eSpark-Consulting-Group/elijahkorp-controlproject/Design_files/Control_Board/Deliverables/Renderings/3D_Isometric.PNG

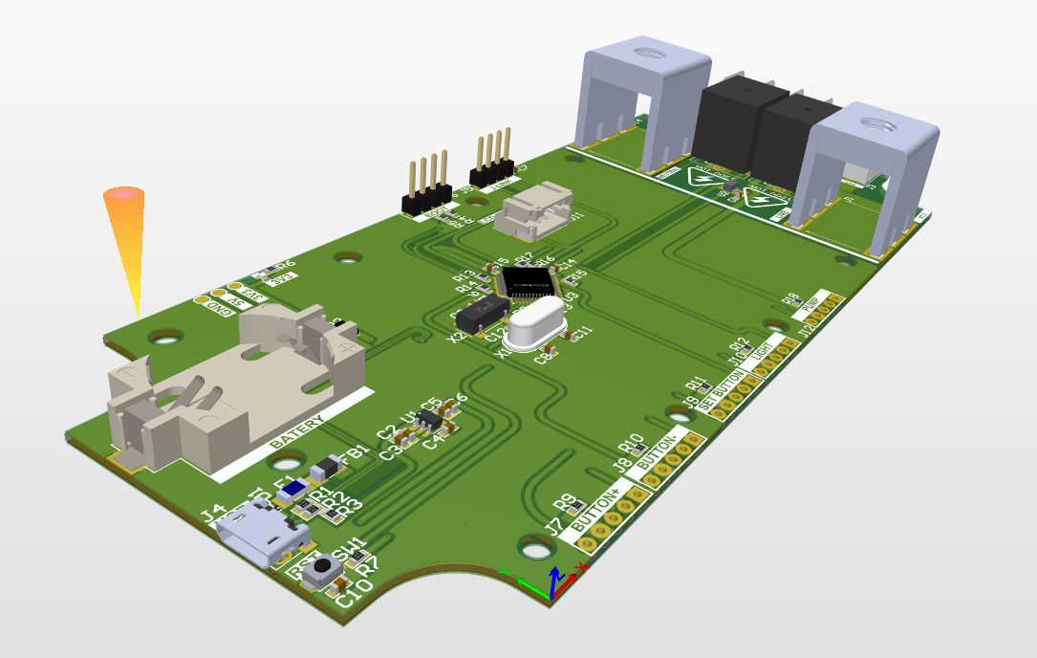
Design_files/Control_Board/Deliverables/Renderings/3D_Isometric.PNG
