eSpark-Consulting-Group/elijahkorp-controlproject/Design_files/Control_Board/Deliverables/Renderings/2D_Top_View.PNG

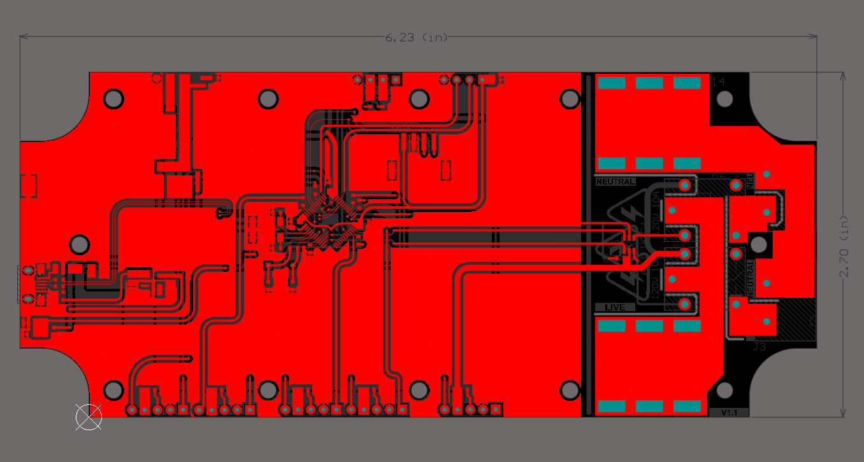
Design_files/Control_Board/Deliverables/Renderings/2D_Top_View.PNG
