eSpark-Consulting-Group/elijahkorp-controlproject/Design_files/Control_Board/Deliverables/Renderings/3D_Bottom.PNG

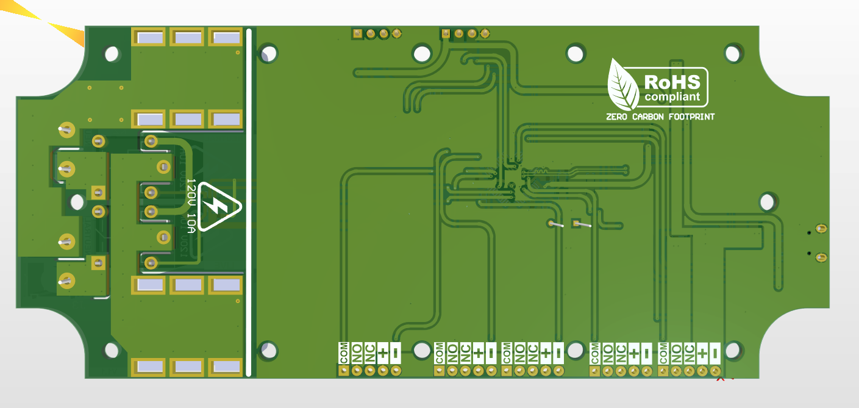
Design_files/Control_Board/Deliverables/Renderings/3D_Bottom.PNG
