eSpark-Consulting-Group/elijahkorp-controlproject/Design_files/Control_Board/Deliverables/BOM/Client BOM.xlsx

Sheet: 5 Boards
 |  | Component list |  | Bill of Materials for Project [Control_Board.]
 |  | Source Data From: |  | Control_Board
 |  | Project: |  | Control_Board
 |  | Variant: |  | None
# | Item Type | Designator | Description | Footprint | Manufacturer Part Number | Manufacturer | Value | Quantity | Quantity (10 Boards) | Link | Remarks
1 | Capacitor | C1, C2, C5, C7, C13, C14, C15, C16 | CS Series 0603 0.1 uF 25 V ±10% X7R Multilayer Ceramic Capacitor | Cap-0603 | CS0603KRX7R8BB104 | Yageo | 0.1uF | 8 | 40
2 | Capacitor | C3, C6 | CAP CER 10UF 25V X5R 0603 | Cap-0603 | CL10A106MA8NRNC | Samsung | 10uF | 2 | 10
3 | Capacitor | C4 | 25V 22nF X7R 0603 Multilayer Ceramic Capacitors MLCC - SMD/SMT ROHS | Cap-0603 | FN18X223K250PSG | PSA(Prosperity Dielectrics) | 22nF | 1 | 5
4 | Capacitor | C8, C11 | CAP 30pF NP0 0603 50 V ±5 % SMD | Cap-0603 | CC0603JRNPO9BN300 | Yageo | 30pF | 2 | 10
5 | Capacitor | C9, C12 | CAP CER 15PF 50V C0G/NPO 0603 | Cap-0603 | CC0603JRNPO9BN150 | Yageo | 15pF | 2 | 10
6 | Capacitor | C10 | 1uF 25V X5R ±20% 0603 Multilayer Ceramic Capacitors MLCC - SMD/SMT ROHS | Cap-0603 | TCC0603X5R105M250CT | CCTC | 1uF | 1 | 5
7 | Diode | D1 | TVS DIODE 5VWM 6.3VC DSN0603-2 | DSN0603-2 | PESD5V0H1BSFYL | Nexperia | - | 1 | 5
8 | Diode | D2 | 30V Dual Common Cathode 1V@100mA 200mA SOT-23(TO-236) Schottky Barrier Diodes (SBD) ROHS | SOT-23 | BAT54C | Shandong Jingdao Microelectronics | - | 1 | 5
9 | Fuse | F1 | PTC RESET FUSE 6V 3A 1206 | Fuse 1206 (3216 Metric) | 1206L300SLTHYR | Littelfuse | - | 1 | 5
10 | Ferrite Bead | FB1 | FERRITE BEAD 120 OHM 1206 1LN | IND-1206 | BLM31PG121SN1L | Murata | - | 1 | 5
11 | PCB Welding Terminal | J1, J14 | 7.5mm 240A 20mm M6 - PCB Welding Terminal ROHS | ACTB273-CU-T2 | ACTB273-Cu-T2 | CNNT(Shenzhen Connection Elec) |  | 2 | 10
12 | Terminal Block | J1, J2, J3 | Tin 2x1P 2 1 7.62mm -40℃~+105℃ 20A 300V Green 12~22 Straight pin Copper Alloy 2.5 Plugin,P=7.62mm Barrier Terminal Blocks ROHS | Custom | MX7620-7.62-02P-GN01-Cu-S-A | MAX | - | 3 | 15
13 | USB | J4 | 1.8A USB 2.0 1 260℃ Surface Mount 5P Female -40℃~+85℃ Gold Copper Alloy Micro-B SMD USB Connectors ROHS | Custom | U254-051T-4BH83-F1S | XKB Connectivity | - | 1 | 5
14 | Header | J5, J6 | Straight 2.54mm Black Brass 1x4P Plugin,P=2.54mm Pin Headers ROHS | HDR1X4_ | B-2100S04P-A110 | Ckmtw | - | 2 | 10
15 | Through Hole Pads | J7, J8, J9, J10, J12 | Wire Connecting Pads | Custom | 5P Through Hole Pads |  | DNP | 5 | 25
16 | Connector | J11 | 1x4P 1 2mm Male pin 4 -25℃~+85℃ 2A Surface Mount SMD,P=2mm Wire To Board / Wire To Wire Connector ROHS C3029442 | Custom | WAFER-PH2.0-4PWB | XUNPU | - | 1 | 5
17 | Connector | J13 | Battery base CR2032 SMD Battery Connectors ROHS | Custom | CR2032-BS-6-1 | Q&J | - | 1 | 5
18 | Relay | K1, K2 | 5V 10A 20A@14VAC SPDT (1 Form C) 5 Plugin,12.4x16mm Power Relays ROHS | Custom | SRA-05VDC-CL | Ningbo Songle Relay | - | 2 | 10
19 | LED | LED6 | Colorless transparence -30℃~+85℃ Positive post 617nm~621nm Red 120° 55mW 0603 Light Emitting Diodes (LED) ROHS | LED-0603 | XL-1608SURC-06 | XINGLIGHT | - | 1 | 5
20 | TEST POINT | P1, P2, P3 | Test Point ON | Custom | Test-point | - | - | 3 | 15
21 | Resistor | R1, R2 | 100mW Thick Film Resistors ±100ppm/℃ ±1% 20Ω 0603 Chip Resistor - Surface Mount ROHS | Res-0603 | 0603WAF200JT5E | UNI-ROYAL(Uniroyal Elec) | 20R | 2 | 10
22 | Resistor | R3 | RES SMD 4.7K OHM 5% 1/10W 0603 | Res-0603 | RC0603JR-074K7L | Yageo | 4.7K | 1 | 5
23 | Resistor | R6 | 100mW Thick Film Resistors ±100ppm/℃ ±1% 60.4Ω 0603 Chip Resistor - Surface Mount ROHS | Res-0603 | RTT0360R4FTP | RALEC | 60.4R | 1 | 5
24 | Resistor | R4, R5, R9, R10, R11, R12, R18,R7 | RES SMD 10K Ohm 1% 1/10W 0603 | Res-0603 | RC0603FR-0710KL | Yageo | 10K | 8 | 40
25 | Resistor | R8 | 100mW Thick Film Resistors ±100ppm/℃ ±1% 1MΩ 0603 Chip Resistor - Surface Mount ROHS | Res-0603 | 0603WAF1004T5E | UNI-ROYAL(Uniroyal Elec) | 1M | 1 | 5
26 | Resistor | R13, R14, R15, R16, R17 | RES SMD 330R 100 mW 0603 | Res-0603 | RC0603JR-07330RL | Yageo | 330R | 5 | 25
27 | Switch | SW1 | SWITCH TACTILE SPST-NO 0.05A 12V | Custom | B3U-1000P | Omron | - | 1 | 5
28 | IC | U1 | IC REG LDO 3.3V 0.3A SOT23-5 | SOT-23-5 | RT9193-33GB | Richtek | - | 1 | 5
29 | IC | U2 | SOT-23-6 Darlington Transistor Arrays ROHS | SOT-23-6 | LK1802 | LANKE | - | 1 | 5
30 | IC | U3 | ARM Cortex-M3 STM32 F1 Microcontroller 32-Bit 72MHz 64kB FLASH LQFP48 STM32F103C8T6 | 48-LQFP (7x7)_ | STM32F103C8T6 | STMicroelectronics | - | 1 | 5
31 | Crystal | X1 | 8MHz 20pF ±20ppm HC-49S Crystals ROHS | Custom | 71008000RW1 | HD | 8Mhz | 1 | 5
32 | Crystal | X2 | 32.768kHz 12.5pF ±20ppm MC-306 Crystals ROHS | Custom | MC-306 | Seiko Epson | 32.768kHz | 1 | 5
33 | Peripheral | - | 19mm Waterproof Momentary Latching Metal Doorbell Bell Horn Push Button Switch LED Ring Mark Fixation 5V 12V 24V 220 Lock Reset | - | White LED Button | - |  | 3 | 15 | Aliexpress (https://vi.aliexpress.com/item/32899654309.html?gatewayAdapt=glo2vnm)
34 | Peripheral | - | 19mm Waterproof Momentary Latching Metal Doorbell Bell Horn Push Button Switch LED Ring Mark Fixation 5V 12V 24V 220 Lock Reset | - | Red LED Button | - |  | 2 | 10 | Aliexpress (https://vi.aliexpress.com/item/32899654309.html?gatewayAdapt=glo2vnm)
35 | Peripheral | - | 10A 250V C13 C14 Waterproof Black electric bicycle car wired Receptacle Connector battery Charging AC power outlet Socket | - | - | - | - | 1 | 5 | Aliexpress (https://www.aliexpress.us/item/1005004421431950.html?gatewayAdapt=4itemAdapt)
36 | Peripheral | - | Original For Panasonic CR2032 CR 2032 DL2032 ECR2032 Lithium Battery Watch Calculator Car Key Remote Control Button Coin Cells | - | CR2032 | Panasonic | - | 1 | 5 | Aliexpress (https://vi.aliexpress.com/item/1005005930259581.html)
37 | Peripheral | - | Network cables ROHS | - | LDS200-100726-200-4P | DEALON | - | 1 | 5 | LCSC (https://www.lcsc.com/product-detail/Network-cables_DEALON-LDS200-100726-200-4P_C2999019.html)
38 | Peripheral | - | 162 16X2 1602 AIP31068L Serial I2C IIC Character LCD Module Display Screen LCM for Arduino RaspBerry Pi PICO ESP32 Jetson Nano | - | - | - | - | 1 | 5 | Aliexpress (https://www.aliexpress.com/item/4000386970133.html)

Sheet: 10 Boards
 |  | Component list |  | Bill of Materials for Project [Control_Board.]
 |  | Source Data From: |  | Control_Board
 |  | Project: |  | Control_Board
 |  | Variant: |  | None
# | Item Type | Designator | Description | Footprint | Manufacturer Part Number | Manufacturer | Value | Quantity | Quantity (10 Boards) | Link | Remarks
1 | Capacitor | C1, C2, C5, C7, C13, C14, C15, C16 | CS Series 0603 0.1 uF 25 V ±10% X7R Multilayer Ceramic Capacitor | Cap-0603 | CS0603KRX7R8BB104 | Yageo | 0.1uF | 8 | 80
2 | Capacitor | C3, C6 | CAP CER 10UF 25V X5R 0603 | Cap-0603 | CL10A106MA8NRNC | Samsung | 10uF | 2 | 20
3 | Capacitor | C4 | 25V 22nF X7R 0603 Multilayer Ceramic Capacitors MLCC - SMD/SMT ROHS | Cap-0603 | FN18X223K250PSG | PSA(Prosperity Dielectrics) | 22nF | 1 | 10
4 | Capacitor | C8, C11 | CAP 30pF NP0 0603 50 V ±5 % SMD | Cap-0603 | CC0603JRNPO9BN300 | Yageo | 30pF | 2 | 20
5 | Capacitor | C9, C12 | CAP CER 15PF 50V C0G/NPO 0603 | Cap-0603 | CC0603JRNPO9BN150 | Yageo | 15pF | 2 | 20
6 | Capacitor | C10 | 1uF 25V X5R ±20% 0603 Multilayer Ceramic Capacitors MLCC - SMD/SMT ROHS | Cap-0603 | TCC0603X5R105M250CT | CCTC | 1uF | 1 | 10
7 | Diode | D1 | TVS DIODE 5VWM 6.3VC DSN0603-2 | DSN0603-2 | PESD5V0H1BSFYL | Nexperia | - | 1 | 10
8 | Diode | D2 | 30V Dual Common Cathode 1V@100mA 200mA SOT-23(TO-236) Schottky Barrier Diodes (SBD) ROHS | SOT-23 | BAT54C | Shandong Jingdao Microelectronics | - | 1 | 10
9 | Fuse | F1 | PTC RESET FUSE 6V 3A 1206 | Fuse 1206 (3216 Metric) | 1206L300SLTHYR | Littelfuse | - | 1 | 10
10 | Ferrite Bead | FB1 | FERRITE BEAD 120 OHM 1206 1LN | IND-1206 | BLM31PG121SN1L | Murata | - | 1 | 10
11 | Terminal Block | J1, J2, J3 | Tin 2x1P 2 1 7.62mm -40℃~+105℃ 20A 300V Green 12~22 Straight pin Copper Alloy 2.5 Plugin,P=7.62mm Barrier Terminal Blocks ROHS | Custom | MX7620-7.62-02P-GN01-Cu-S-A | MAX | - | 3 | 30
12 | USB | J4 | 1.8A USB 2.0 1 260℃ Surface Mount 5P Female -40℃~+85℃ Gold Copper Alloy Micro-B SMD USB Connectors ROHS | Custom | U254-051T-4BH83-F1S | XKB Connectivity | - | 1 | 10
13 | Header | J5, J6 | Straight 2.54mm Black Brass 1x4P Plugin,P=2.54mm Pin Headers ROHS | HDR1X4_ | B-2100S04P-A110 | Ckmtw | - | 2 | 20
14 | Through Hole Pads | J7, J8, J9, J10, J12 | Wire Connecting Pads | Custom | 5P Through Hole Pads | - | DNP | 5 | 50
15 | Connector | J11 | 1x4P 1 2mm Male pin 4 -25℃~+85℃ 2A Surface Mount SMD,P=2mm Wire To Board / Wire To Wire Connector ROHS C3029442 | Custom | WAFER-PH2.0-4PWB | XUNPU | - | 1 | 10
16 | Connector | J13 | Battery base CR2032 SMD Battery Connectors ROHS | Custom | CR2032-BS-6-1 | Q&J | - | 1 | 10
17 | Relay | K1, K2 | 5V 10A 20A@14VAC SPDT (1 Form C) 5 Plugin,12.4x16mm Power Relays ROHS | Custom | SRA-05VDC-CL | Ningbo Songle Relay | - | 2 | 20
18 | LED | LED6 | Colorless transparence -30℃~+85℃ Positive post 617nm~621nm Red 120° 55mW 0603 Light Emitting Diodes (LED) ROHS | LED-0603 | XL-1608SURC-06 | XINGLIGHT | - | 1 | 10
19 | TEST POINT | P1, P2, P3 | Test Point ON | Custom | Test-point | - | - | 3 | 30
20 | Resistor | R1, R2 | 100mW Thick Film Resistors ±100ppm/℃ ±1% 20Ω 0603 Chip Resistor - Surface Mount ROHS | Res-0603 | 0603WAF200JT5E | UNI-ROYAL(Uniroyal Elec) | 20R | 2 | 20
21 | Resistor | R3 | 100mW Thick Film Resistors ±100ppm/℃ ±1% 1.5kΩ 0603 Chip Resistor - Surface Mount ROHS | Res-0603 | 0603WAF1501T5E | UNI-ROYAL(Uniroyal Elec) | 1.5K | 1 | 10
22 | Resistor | R4, R5, R9, R10, R11, R12, R18 | RES SMD 10K OHM 0.1% 1/10W 0603 | Res-0603 | RT0603BRD0710KL | Yageo | 10K | 7 | 70
23 | Resistor | R6 | 100mW Thick Film Resistors ±100ppm/℃ ±1% 60.4Ω 0603 Chip Resistor - Surface Mount ROHS | Res-0603 | RTT0360R4FTP | RALEC | 60.4R | 1 | 10
24 | Resistor | R7 | RES SMD 10K Ohm 1% 1/10W 0603 | Res-0603 | RC0603FR-0710KL | Yageo | 10K | 1 | 10
25 | Resistor | R8 | 100mW Thick Film Resistors ±100ppm/℃ ±1% 1MΩ 0603 Chip Resistor - Surface Mount ROHS | Res-0603 | 0603WAF1004T5E | UNI-ROYAL(Uniroyal Elec) | 1M | 1 | 10
26 | Resistor | R13, R14, R15, R16, R17 | RES SMD 330R 100 mW 0603 | Res-0603 | RC0603JR-07330RL | Yageo | 330R | 5 | 50
27 | Switch | SW1 | SWITCH TACTILE SPST-NO 0.05A 12V | Custom | B3U-1000P | Omron | - | 1 | 10
28 | IC | U1 |  | SOT-23-5 | RT9193-33GB | Richtek | - | 1 | 10
29 | IC | U2 | SOT-23-6 Darlington Transistor Arrays ROHS | SOT-23-6 | LK1802 | LANKE | - | 1 | 10
30 | IC | U3 | Mainstream Performance line, Arm | 48-LQFP (7x7)_ | STM32F103C8T6 | STMicroelectronics | - | 1 | 10
31 | Crystal | X1 | 8MHz 20pF ±20ppm HC-49S Crystals ROHS | Custom | 71008000RW1 | HD | 8Mhz | 1 | 10
32 | Crystal | X2 | 32.768kHz 12.5pF ±20ppm MC-306 Crystals ROHS | Custom | MC-306 | Seiko Epson | 32.768kHz | 1 | 10
33 | Peripheral | - | 19mm Waterproof Momentary Latching Metal Doorbell Bell Horn Push Button Switch LED Ring Mark Fixation 5V 12V 24V 220 Lock Reset | - | White LED Button | - |  | 3 | 30 | Aliexpress (https://vi.aliexpress.com/item/32899654309.html?gatewayAdapt=glo2vnm)
34 | Peripheral | - | 19mm Waterproof Momentary Latching Metal Doorbell Bell Horn Push Button Switch LED Ring Mark Fixation 5V 12V 24V 220 Lock Reset | - | Red LED Button | - |  | 2 | 20 | Aliexpress (https://vi.aliexpress.com/item/32899654309.html?gatewayAdapt=glo2vnm)
35 | Peripheral | - | 10A 250V C13 C14 Waterproof Black electric bicycle car wired Receptacle Connector battery Charging AC power outlet Socket | - | - | - | - | 1 | 10 | Aliexpress (https://www.aliexpress.us/item/1005004421431950.html?gatewayAdapt=4itemAdapt)
36 | Peripheral | - | Original For Panasonic CR2032 CR 2032 DL2032 ECR2032 Lithium Battery Watch Calculator Car Key Remote Control Button Coin Cells | - | CR2032 | Panasonic | - | 1 | 10 | Aliexpress (https://vi.aliexpress.com/item/1005005930259581.html)
37 | Peripheral | - | Network cables ROHS | - | LDS200-100726-200-4P | DEALON | - | 1 | 10 | LCSC (https://www.lcsc.com/product-detail/Network-cables_DEALON-LDS200-100726-200-4P_C2999019.html)
38 | Peripheral | - | 162 16X2 1602 AIP31068L Serial I2C IIC Character LCD Module Display Screen LCM for Arduino RaspBerry Pi PICO ESP32 Jetson Nano | - | - | - | - | 1 | 10 | Aliexpress (https://www.aliexpress.com/item/4000386970133.html)
