eSpark-Consulting-Group/elijahkorp-controlproject/Design_files/Control_Board/Deliverables/BOM/eSpark-BOM-Control_Board-v1.0.xlsx

Sheet: 5 Boards
 |  | Component list |  | Bill of Materials for Project [Control_Board-v1.0]
 |  | Source Data From: |  | Control_Board-v1.0
 |  | Project: |  | Control_Board-v1.0
 |  | Variant: |  | None
# | Item Type | Designator | Description | Footprint | Manufacturer Part Number | Manufacturer | Alternate Part Number | LCSC Part Number | Value | Quantity | Quantity (5 Boards) | MOQ (5 Boards) | Links | Unit Cost (5 Boards) | Total Cost (5 Boards) | Remarks | Reviewer Remarks
1 | Capacitor | C1, C2, C5, C7, C13, C14, C15, C16 | CAP CER 0.1UF 25V X7R 0603 | Cap-0603 | CS0603KRX7R8BB104 | Yageo | - | C577419 | 0.1uF | 8 | 40 | 50 | LCSC (https://www.lcsc.com/product-detail/Multilayer-Ceramic-Capacitors-MLCC-SMD-SMT_YAGEO-CS0603KRX7R8BB104_C577419.html) | $0.0117 | $0.5850
2 | Capacitor | C3, C6 | CAP CER 10UF 25V X5R 0603 | Cap-0603 | CL10A106MA8NRNC | Samsung | - | C96446 | 10uF | 2 | 10 | 20 | LCSC (https://www.lcsc.com/product-detail/Multilayer-Ceramic-Capacitors-MLCC-SMD-SMT_Samsung-Electro-Mechanics-CL10A106MA8NRNC_C96446.html) | $0.0193 | $0.3860
3 | Capacitor | C4 | 25V 22nF X7R 0603 Multilayer Ceramic Capacitors MLCC - SMD/SMT ROHS | Cap-0603 | FN18X223K250PSG | PSA(Prosperity Dielectrics) | - | C2929161 | 22nF | 1 | 5 | 100 | LCSC (https://www.lcsc.com/product-detail/Multilayer-Ceramic-Capacitors-MLCC-SMD-SMT_PSA-Prosperity-Dielectrics-FN18X223K250PSG_C2929161.html) | $0.0039 | $0.3900
4 | Capacitor | C8, C11 | CAP 30pF NP0 0603 50 V ±5 % SMD | Cap-0603 | CC0603JRNPO9BN300 | Yageo | - | C113797 | 30pF | 2 | 10 | 100 | LCSC (https://www.lcsc.com/product-detail/Multilayer-Ceramic-Capacitors-MLCC-SMD-SMT_YAGEO-CC0603JRNPO9BN300_C113797.html) | $0.0029 | $0.2900
5 | Capacitor | C9, C12 | CAP CER 15PF 50V C0G/NPO 0603 | Cap-0603 | CC0603JRNPO9BN150 | Yageo | - | C107037 | 15pF | 2 | 10 | 100 | LCSC (https://www.lcsc.com/product-detail/Multilayer-Ceramic-Capacitors-MLCC-SMD-SMT_YAGEO-CC0603JRNPO9BN150_C107037.html) | $0.0030 | $0.3000
6 | Capacitor | C10 | 1uF 25V X5R ±20% 0603 Multilayer Ceramic Capacitors MLCC - SMD/SMT ROHS | Cap-0603 | TCC0603X5R105M250CT | CCTC | - | C6266891 | 1uF | 1 | 5 | 100 | LCSC (https://www.lcsc.com/product-detail/Multilayer-Ceramic-Capacitors-MLCC-SMD-SMT_CCTC-TCC0603X5R105M250CT_C6266891.html) | $0.0042 | $0.4200
7 | Diode | D1 | TVS DIODE 5VWM 6.3VC DSN0603-2 | DSN0603-2 | PESD5V0H1BSFYL | Nexperia | - | C477989 | - | 1 | 5 | 10 | LCSC (https://www.lcsc.com/product-detail/ESD-Protection-Devices_Nexperia-PESD5V0H1BSF_C477989.html) | $0.0339 | $0.3390
8 | Diode | D2 | 30V Dual Common Cathode 1V@100mA 200mA SOT-23 Schottky Barrier Diodes (SBD) ROHS | SOT-23 | BAT54C | Shandong Jingdao Microelectronics | - | C727125 | - | 1 | 5 | 50 | LCSC (https://www.lcsc.com/product-detail/Schottky-Barrier-Diodes-SBD_TWGMC-BAT54C_C727125.html) | $0.0103 | $0.5150
9 | Fuse | F1 | PTC RESET FUSE 6V 3A 1206 | Fuse 1206 (3216 Metric) | 1206L300SLTHYR | Littelfuse | - | C207041 | - | 1 | 5 | 10 | LCSC (https://www.lcsc.com/product-detail/Resettable-Fuses_Littelfuse-1206L300SLTHYR_C207041.html) | $0.2237 | $2.2370
10 | Ferrite Bead | FB1 | FERRITE BEAD 120 OHM 1206 1LN | IND-1206 | BLM31PG121SN1L | Murata | - | C85841 | - | 1 | 5 | 10 | LCSC (https://www.lcsc.com/product-detail/Ferrite-Beads_Murata-Electronics-BLM31PG121SN1L_C85841.html) | $0.0803 | $0.8030
11 | PCB Welding Terminal | J1, J14 | 7.5mm 240A 20mm M6 - PCB Welding Terminal ROHS | ACTB273-CU-T2 | ACTB273-Cu-T2 | CNNT(Shenzhen Connection Elec) |  | - | - | 2 | 10 | 10 | JLCPCB (https://jlcpcb.com/partdetail/5781967-ACTB273_CuT2/C5154233) | $1.5135 | $15.1350
12 | Terminal Block | J1, J2, J3 | Tin 2x1P 2 1 7.62mm -40℃~+105℃ 20A 300V Green 12~22 Straight pin Copper Alloy 2.5 Plugin,P=7.62mm Barrier Terminal Blocks ROHS | Custom | MX7620-7.62-02P-GN01-Cu-S-A | MAX | - | C5188497 | - | 3 | 15 | 20 | LCSC (https://www.lcsc.com/product-detail/Barrier-Terminal-Blocks_MAX-MX7620-7-62-02P-GN01-Cu-S-A_C5188497.html) | $0.0758 | $1.5160
13 | USB | J4 | 1.8A USB 2.0 1 260℃ Surface Mount 5P Female -40℃~+85℃ Gold Copper Alloy Micro-B SMD USB Connectors ROHS | Custom | U254-051T-4BH83-F1S | XKB Connectivity | - | C397452 | - | 1 | 5 | 10 | LCSC (https://www.lcsc.com/product-detail/USB-Connectors_XKB-Connectivity-U254-051T-4BH83-F1S_C397452.html) | $0.0404 | $0.4040
14 | Header | J5, J6 | Straight 2.54mm Black Brass 1x4P Plugin,P=2.54mm Pin Headers ROHS | HDR1X4_ | B-2100S04P-A110 | Ckmtw | - | C124378 |  | 2 | 10 | 20 | LCSC (https://www.lcsc.com/product-detail/Pin-Headers_Ckmtw-Shenzhen-Cankemeng-B-2100S04P-A110_C124378.html) | $0.0402 | $0.8040
15 | Through Hole Pads | ~~J7, J8, J9, J10, J12~~ | ~~Wire Connecting Pads~~ | ~~Custom~~ | ~~5P Through Hole Pads~~ | ~~-~~ | ~~-~~ | ~~-~~ | ~~DNP~~ | ~~5~~ | ~~25~~ | ~~-~~ | ~~-~~ | ~~-~~ | ~~-~~
16 | Connector | J11 | 1x4P 1 2mm Male pin 4 -25℃~+85℃ 2A Surface Mount SMD,P=2mm Wire To Board / Wire To Wire Connector ROHS C3029442 | Custom | WAFER-PH2.0-4PWB | XUNPU | - | C3029442 | - | 1 | 5 | 10 | LCSC (https://www.lcsc.com/product-detail/Wire-To-Board-Wire-To-Wire-Connector_XUNPU-WAFER-PH2-0-4PWB_C3029442.html) | $0.0624 | $0.6240
17 | Connector | J13 | Battery base CR2032 SMD Battery Connectors ROHS | Custom | CR2032-BS-6-1 | Q&J | - | C70377 |  | 1 | 5 | 10 | LCSC (https://www.lcsc.com/product-detail/Battery-Connectors_Q-J-CR2032-BS-6-1_C70377.html) | $0.1559 | $1.5590
18 | Relay | K1, K2 | 5V 10A 20A@14VAC SPDT (1 Form C) 5 Plugin,12.4x16mm Power Relays ROHS | Custom | SRA-05VDC-CL | Ningbo Songle Relay | - | C99666 |  | 2 | 10 | 15 | LCSC (https://www.lcsc.com/product-detail/Power-Relays_Ningbo-Songle-Relay-SRA-05VDC-CL_C99666.html) | $0.3444 | $5.1660
19 | LED | LED6 | Colorless transparence -30℃~+85℃ Positive post 617nm~621nm Red 120° 55mW 0603 Light Emitting Diodes (LED) ROHS | LED-0603 | XL-1608SURC-06 | XINGLIGHT | - | C965799 |  | 1 | 5 | 100 | LCSC (https://www.lcsc.com/product-detail/Light-Emitting-Diodes-LED_XINGLIGHT-XL-1608SURC-06_C965799.html) | $0.0026 | $0.2600
20 | TEST POINT | ~~P1, P2, P3~~ | ~~Test Point ON~~ | ~~Custom~~ | ~~Test-point~~ | ~~-~~ | ~~-~~ | ~~-~~ |  | ~~3~~ | ~~15~~ | ~~-~~ | ~~-~~ | ~~-~~ | ~~-~~
21 | Resistor | R1, R2 | 100mW Thick Film Resistors ±100ppm/℃ ±1% 20Ω 0603 Chip Resistor - Surface Mount ROHS | Res-0603 | 0603WAF200JT5E | UNI-ROYAL(Uniroyal Elec) | - | C22950 | 20R | 2 | 10 | 100 | LCSC (https://www.lcsc.com/product-detail/Chip-Resistor-Surface-Mount_UNI-ROYAL-Uniroyal-Elec-0603WAF200JT5E_C22950.html) | $0.0010 | $0.1000
22 | Resistor | R3 | RES SMD 4.7K OHM 5% 1/10W 0603 | Res-0603 | RC0603JR-074K7L | Yageo |  | C105428 | 4.7K | 1 | 5 | 100 | LCSC (https://www.lcsc.com/product-detail/Chip-Resistor-Surface-Mount_YAGEO-RC0603JR-074K7L_C105428.html) | $0.0011 | $0.1100
23 | Resistor | R6 | 100mW Thick Film Resistors ±100ppm/℃ ±1% 60.4Ω 0603 Chip Resistor - Surface Mount ROHS | Res-0603 | RTT0360R4FTP | RALEC | - | C103744 | 60.4R | 1 | 5 | 100 | LCSC (https://www.lcsc.com/product-detail/Chip-Resistor-Surface-Mount_RALEC-RTT0360R4FTP_C103744.html) | $0.0010 | $0.1000
24 | Resistor | R4, R5, R9, R10, R11, R12, R18,R7 | RES SMD 10K Ohm 1% 1/10W 0603 | Res-0603 | RC0603FR-0710KL | Yageo | - | C98220 | 10K | 8 | 40 | 100 | LCSC (https://www.lcsc.com/product-detail/Chip-Resistor-Surface-Mount_YAGEO-RC0603FR-0710KL_C98220.html) | $0.0010 | $0.1000
25 | Resistor | R8 | 100mW Thick Film Resistors ±100ppm/℃ ±1% 1MΩ 0603 Chip Resistor - Surface Mount ROHS | Res-0603 | 0603WAF1004T5E | UNI-ROYAL(Uniroyal Elec) | - | C22935 | 1M | 1 | 5 | 100 | LCSC (https://www.lcsc.com/product-detail/Chip-Resistor-Surface-Mount_UNI-ROYAL-Uniroyal-Elec-0603WAF1004T5E_C22935.html) | $0.0010 | $0.1000
26 | Resistor | R13, R14, R15, R16, R17 | RES SMD 330R 100 mW 0603 | Res-0603 | RC0603JR-07330RL | Yageo | - | C105879 | 330R | 5 | 25 | 100 | LCSC (https://www.lcsc.com/product-detail/Chip-Resistor-Surface-Mount_YAGEO-RC0603JR-07330RL_C105879.html) | $0.0011 | $0.1100
27 | Switch | SW1 | SWITCH TACTILE SPST-NO 0.05A 12V | Custom | B3U-1000P | Omron | - | C231329 | - | 1 | 5 | 10 | LCSC (https://www.lcsc.com/product-detail/Tactile-Switches_Omron-Electronics-B3U-1000P_C231329.html) | $0.1729 | $1.7290
28 | IC | U1 | IC REG LDO 3.3V 0.3A SOT23-5 | SOT-23-5 | RT9193-33GB | Richtek | - | C15651 | - | 1 | 5 | 10 | LCSC (https://www.lcsc.com/product-detail/Linear-Voltage-Regulators-LDO_Richtek-Tech-RT9193-33GB_C15651.html) | $0.1154 | $1.1540
29 | IC | U2 | SOT-23-6 Darlington Transistor Arrays ROHS | SOT-23-6 | LK1802 | LANKE | - | C2984831 | - | 1 | 5 | 10 | LCSC (https://www.lcsc.com/product-detail/Darlington-Transistor-Arrays_LANKE-LK1802_C2984831.html) | $0.0531 | $0.5310
30 | IC | U3 | Mainstream Performance line, Arm | 48-LQFP (7x7)_ | STM32F103C8T6 | STMicroelectronics | - | C8734 | - | 1 | 5 | 6 | LCSC (https://www.lcsc.com/product-detail/Microcontroller-Units-MCUs-MPUs-SOCs_STMicroelectronics-STM32F103C8T6_C8734.html) | $1.4207 | $8.5242
31 | Crystal | X1 | 8MHz 20pF ±20ppm HC-49S Crystals ROHS | Custom | 71008000RW1 | HD | - | C655216 | 8Mhz | 1 | 5 | 10 | LCSC (https://www.lcsc.com/product-detail/Crystals_HD-71008000RW1_C655216.html) | $0.0574 | $0.5740
32 | Crystal | X2 | 32.768kHz 12.5pF ±20ppm MC-306 Crystals ROHS | Custom | MC-306 | Seiko Epson | - | C2650464 | 32.768kHz | 1 | 5 | 10 | LCSC (https://www.lcsc.com/product-detail/Crystals_Seiko-Epson-MC-306-32-7680K-A0-ROHS_C2650464.html) | $0.2728 | $2.7280
33 | Peripheral | - | 19mm Waterproof Momentary Latching Metal Doorbell Bell Horn Push Button Switch LED Ring Mark Fixation 5V 12V 24V 220 Lock Reset | - | White LED Button | - | - | - | - | 3 | 15 | 17 | Aliexpress (https://vi.aliexpress.com/item/32899654309.html?gatewayAdapt=glo2vnm) | $0.6900 | $11.7300
34 | Peripheral | - | 19mm Waterproof Momentary Latching Metal Doorbell Bell Horn Push Button Switch LED Ring Mark Fixation 5V 12V 24V 220 Lock Reset | - | Red LED Button | - | - | - | - | 2 | 10 | 12 | Aliexpress (https://vi.aliexpress.com/item/32899654309.html?gatewayAdapt=glo2vnm) | $0.6900 | $8.2800
35 | Peripheral | - | 10A 250V C13 C14 Waterproof Black electric bicycle car wired Receptacle Connector battery Charging AC power outlet Socket | - | - | - | - | - | - | 1 | 5 | 5 | Aliexpress (https://www.aliexpress.us/item/1005004421431950.html?gatewayAdapt=4itemAdapt) | $3.2300 | $16.1500
36 | Peripheral | - | Original For Panasonic CR2032 CR 2032 DL2032 ECR2032 Lithium Battery Watch Calculator Car Key Remote Control Button Coin Cells | - | CR2032 | Panasonic | - | - | - | 1 | 5 | 5 | Aliexpress (https://vi.aliexpress.com/item/1005005930259581.html) | $3.1800 | $15.9000
37 | Peripheral | - | Network cables ROHS | - | LDS200-100726-200-4P | DEALON | - | C2999019 | - | 1 | 5 | 5 | LCSC (https://www.lcsc.com/product-detail/Network-cables_DEALON-LDS200-100726-200-4P_C2999019.html) | $0.1147 | $0.5735
38 | Peripheral | - | 162 16X2 1602 AIP31068L Serial I2C IIC Character LCD Module Display Screen LCM for Arduino RaspBerry Pi PICO ESP32 Jetson Nano | - | - | - | - | - | - | 1 | 5 | 5 | Aliexpress (https://www.aliexpress.com/item/4000386970133.html) | $6.2900 | $31.4500
 |  |  |  |  |  |  |  |  |  |  |  | Total Component Cost |  |  | $131.68
 |  |  |  |  |  |  |  |  |  |  |  | Single Board Cost |  |  | $26.34

Sheet: 10 Boards
 |  | Component list |  | Bill of Materials for Project [Control_Board-v1.0]
 |  | Source Data From: |  | Control_Board-v1.0
 |  | Project: |  | Control_Board-v1.0
 |  | Variant: |  | None
# | Item Type | Designator | Description | Footprint | Manufacturer Part Number | Manufacturer | Alternate Part Number | LCSC Part Number | Value | Quantity | Quantity (10 Boards) | MOQ (10 Boards) | Links | Unit Cost (10 Boards) | Total Cost (10 Boards) | Remarks | Reviewer Remarks
1 | Capacitor | C1, C2, C5, C7, C13, C14, C15, C16 | CAP CER 0.1UF 25V X7R 0603 | Cap-0603 | CS0603KRX7R8BB104 | Yageo | - | C577419 | 0.1uF | 8 | 80 | 100 | LCSC (https://www.lcsc.com/product-detail/Multilayer-Ceramic-Capacitors-MLCC-SMD-SMT_YAGEO-CS0603KRX7R8BB104_C577419.html) | $0.0117 | $1.1700
2 | Capacitor | C3, C6 | CAP CER 10UF 25V X5R 0603 | Cap-0603 | CL10A106MA8NRNC | Samsung | - | C96446 | 10uF | 2 | 20 | 40 | LCSC (https://www.lcsc.com/product-detail/Multilayer-Ceramic-Capacitors-MLCC-SMD-SMT_Samsung-Electro-Mechanics-CL10A106MA8NRNC_C96446.html) | $0.0193 | $0.7720
3 | Capacitor | C4 | 25V 22nF X7R 0603 Multilayer Ceramic Capacitors MLCC - SMD/SMT ROHS | Cap-0603 | FN18X223K250PSG | PSA(Prosperity Dielectrics) | - | C2929161 | 22nF | 1 | 10 | 100 | LCSC (https://www.lcsc.com/product-detail/Multilayer-Ceramic-Capacitors-MLCC-SMD-SMT_PSA-Prosperity-Dielectrics-FN18X223K250PSG_C2929161.html) | $0.0039 | $0.3900
4 | Capacitor | C8, C11 | CAP 30pF NP0 0603 50 V ±5 % SMD | Cap-0603 | CC0603JRNPO9BN300 | Yageo | - | C113797 | 30pF | 2 | 20 | 100 | LCSC (https://www.lcsc.com/product-detail/Multilayer-Ceramic-Capacitors-MLCC-SMD-SMT_YAGEO-CC0603JRNPO9BN300_C113797.html) | $0.0029 | $0.2900
5 | Capacitor | C9, C12 | CAP CER 15PF 50V C0G/NPO 0603 | Cap-0603 | CC0603JRNPO9BN150 | Yageo | - | C107037 | 15pF | 2 | 20 | 100 | LCSC (https://www.lcsc.com/product-detail/Multilayer-Ceramic-Capacitors-MLCC-SMD-SMT_YAGEO-CC0603JRNPO9BN150_C107037.html) | $0.0030 | $0.3000
6 | Capacitor | C10 | 1uF 25V X5R ±20% 0603 Multilayer Ceramic Capacitors MLCC - SMD/SMT ROHS | Cap-0603 | TCC0603X5R105M250CT | CCTC | - | C6266891 | 1uF | 1 | 10 | 100 | LCSC (https://www.lcsc.com/product-detail/Multilayer-Ceramic-Capacitors-MLCC-SMD-SMT_CCTC-TCC0603X5R105M250CT_C6266891.html) | $0.0042 | $0.4200
7 | Diode | D1 | TVS DIODE 5VWM 6.3VC DSN0603-2 | DSN0603-2 | PESD5V0H1BSFYL | Nexperia | - | C477989 | - | 1 | 10 | 20 | LCSC (https://www.lcsc.com/product-detail/ESD-Protection-Devices_Nexperia-PESD5V0H1BSF_C477989.html) | $0.0339 | $0.6780
8 | Diode | D2 | 30V Dual Common Cathode 1V@100mA 200mA SOT-23 Schottky Barrier Diodes (SBD) ROHS | SOT-23 | BAT54C | Shandong Jingdao Microelectronics | - | C727125 | - | 1 | 10 | 50 | LCSC (https://www.lcsc.com/product-detail/Schottky-Barrier-Diodes-SBD_TWGMC-BAT54C_C727125.html) | $0.0103 | $0.5150
9 | Fuse | F1 | PTC RESET FUSE 6V 3A 1206 | Fuse 1206 (3216 Metric) | 1206L300SLTHYR | Littelfuse | - | C207041 | - | 1 | 10 | 15 | LCSC (https://www.lcsc.com/product-detail/Resettable-Fuses_Littelfuse-1206L300SLTHYR_C207041.html) | $0.2237 | $3.3555
10 | Ferrite Bead | FB1 | FERRITE BEAD 120 OHM 1206 1LN | IND-1206 | BLM31PG121SN1L | Murata | - | C85841 | - | 1 | 10 | 20 | LCSC (https://www.lcsc.com/product-detail/Ferrite-Beads_Murata-Electronics-BLM31PG121SN1L_C85841.html) | $0.0803 | $1.6060
11 | Terminal Block | J1, J2, J3 | Tin 2x1P 2 1 7.62mm -40℃~+105℃ 20A 300V Green 12~22 Straight pin Copper Alloy 2.5 Plugin,P=7.62mm Barrier Terminal Blocks ROHS | Custom | MX7620-7.62-02P-GN01-Cu-S-A | MAX | - | C5188497 | - | 3 | 30 | 35 | LCSC (https://www.lcsc.com/product-detail/Barrier-Terminal-Blocks_MAX-MX7620-7-62-02P-GN01-Cu-S-A_C5188497.html) | $0.0758 | $2.6530
12 | USB | J4 | 1.8A USB 2.0 1 260℃ Surface Mount 5P Female -40℃~+85℃ Gold Copper Alloy Micro-B SMD USB Connectors ROHS | Custom | U254-051T-4BH83-F1S | XKB Connectivity | - | C397452 | - | 1 | 10 | 20 | LCSC (https://www.lcsc.com/product-detail/USB-Connectors_XKB-Connectivity-U254-051T-4BH83-F1S_C397452.html) | $0.0404 | $0.8080
13 | Header | J5, J6 | Straight 2.54mm Black Brass 1x4P Plugin,P=2.54mm Pin Headers ROHS | HDR1X4_ | B-2100S04P-A110 | Ckmtw | - | C124378 |  | 2 | 20 | 40 | LCSC (https://www.lcsc.com/product-detail/Pin-Headers_Ckmtw-Shenzhen-Cankemeng-B-2100S04P-A110_C124378.html) | $0.0402 | $1.6080
14 | Through Hole Pads | ~~J7, J8, J9, J10, J12~~ | ~~Wire Connecting Pads~~ | ~~Custom~~ | ~~5P Through Hole Pads~~ | ~~-~~ | ~~-~~ | ~~-~~ | ~~DNP~~ | ~~5~~ | ~~50~~ | ~~-~~ | ~~-~~ | ~~-~~ | ~~-~~
15 | Connector | J11 | 1x4P 1 2mm Male pin 4 -25℃~+85℃ 2A Surface Mount SMD,P=2mm Wire To Board / Wire To Wire Connector ROHS C3029442 | Custom | WAFER-PH2.0-4PWB | XUNPU | - | C3029442 | - | 1 | 10 | 15 | LCSC (https://www.lcsc.com/product-detail/Wire-To-Board-Wire-To-Wire-Connector_XUNPU-WAFER-PH2-0-4PWB_C3029442.html) | $0.0624 | $0.9360
16 | Connector | J13 | Battery base CR2032 SMD Battery Connectors ROHS | Custom | CR2032-BS-6-1 | Q&J | - | C70377 |  | 1 | 10 | 15 | LCSC (https://www.lcsc.com/product-detail/Battery-Connectors_Q-J-CR2032-BS-6-1_C70377.html) | $0.1559 | $2.3385
17 | Relay | K1, K2 | 5V 10A 20A@14VAC SPDT (1 Form C) 5 Plugin,12.4x16mm Power Relays ROHS | Custom | SRA-05VDC-CL | Ningbo Songle Relay | - | C99666 |  | 2 | 20 | 25 | LCSC (https://www.lcsc.com/product-detail/Power-Relays_Ningbo-Songle-Relay-SRA-05VDC-CL_C99666.html) | $0.3444 | $8.6100
18 | LED | LED6 | Colorless transparence -30℃~+85℃ Positive post 617nm~621nm Red 120° 55mW 0603 Light Emitting Diodes (LED) ROHS | LED-0603 | XL-1608SURC-06 | XINGLIGHT | - | C965799 |  | 1 | 10 | 100 | LCSC (https://www.lcsc.com/product-detail/Light-Emitting-Diodes-LED_XINGLIGHT-XL-1608SURC-06_C965799.html) | $0.0026 | $0.2600
19 | TEST POINT | ~~P1, P2, P3~~ | ~~Test Point ON~~ | ~~Custom~~ | ~~Test-point~~ | ~~-~~ | ~~-~~ | ~~-~~ | ~~DNP~~ | ~~3~~ | ~~30~~ | ~~-~~ | ~~-~~ | ~~-~~ | ~~-~~
20 | Resistor | R1, R2 | 100mW Thick Film Resistors ±100ppm/℃ ±1% 20Ω 0603 Chip Resistor - Surface Mount ROHS | Res-0603 | 0603WAF200JT5E | UNI-ROYAL(Uniroyal Elec) | - | C22950 | 20R | 2 | 20 | 100 | LCSC (https://www.lcsc.com/product-detail/Chip-Resistor-Surface-Mount_UNI-ROYAL-Uniroyal-Elec-0603WAF200JT5E_C22950.html) | $0.0010 | $0.1000
21 | Resistor | R3 | 100mW Thick Film Resistors ±100ppm/℃ ±1% 1.5kΩ 0603 Chip Resistor - Surface Mount ROHS | Res-0603 | 0603WAF1501T5E | UNI-ROYAL(Uniroyal Elec) | - | C22843 | 1.5K | 1 | 10 | 100 | LCSC (https://www.lcsc.com/product-detail/Chip-Resistor-Surface-Mount_UNI-ROYAL-Uniroyal-Elec-0603WAF1501T5E_C22843.html) | $0.0010 | $0.1000
22 | Resistor | R4, R5, R9, R10, R11, R12, R18 | RES SMD 10K OHM 0.1% 1/10W 0603 | Res-0603 | RT0603BRD0710KL | Yageo | - | C95204 | 10K | 7 | 70 | 80 | LCSC (https://www.lcsc.com/product-detail/Chip-Resistor-Surface-Mount_YAGEO-RT0603BRD0710KL_C95204.html) | $0.0212 | $1.6960
23 | Resistor | R6 | 100mW Thick Film Resistors ±100ppm/℃ ±1% 60.4Ω 0603 Chip Resistor - Surface Mount ROHS | Res-0603 | RTT0360R4FTP | RALEC | - | C103744 | 60.4R | 1 | 10 | 100 | LCSC (https://www.lcsc.com/product-detail/Chip-Resistor-Surface-Mount_RALEC-RTT0360R4FTP_C103744.html) | $0.0010 | $0.1000
24 | Resistor | R7 | RES SMD 10K Ohm 1% 1/10W 0603 | Res-0603 | RC0603FR-0710KL | Yageo | - | C98220 | 10K | 1 | 10 | 100 | LCSC (https://www.lcsc.com/product-detail/Chip-Resistor-Surface-Mount_YAGEO-RC0603FR-0710KL_C98220.html) | $0.0010 | $0.1000
25 | Resistor | R8 | 100mW Thick Film Resistors ±100ppm/℃ ±1% 1MΩ 0603 Chip Resistor - Surface Mount ROHS | Res-0603 | 0603WAF1004T5E | UNI-ROYAL(Uniroyal Elec) | - | C22935 | 1M | 1 | 10 | 100 | LCSC (https://www.lcsc.com/product-detail/Chip-Resistor-Surface-Mount_UNI-ROYAL-Uniroyal-Elec-0603WAF1004T5E_C22935.html) | $0.0010 | $0.1000
26 | Resistor | R13, R14, R15, R16, R17 | RES SMD 330R 100 mW 0603 | Res-0603 | RC0603JR-07330RL | Yageo | - | C105879 | 330R | 5 | 50 | 100 | LCSC (https://www.lcsc.com/product-detail/Chip-Resistor-Surface-Mount_YAGEO-RC0603JR-07330RL_C105879.html) | $0.0011 | $0.1100
27 | Switch | SW1 | SWITCH TACTILE SPST-NO 0.05A 12V | Custom | B3U-1000P | Omron | - | C231329 | - | 1 | 10 | 15 | LCSC (https://www.lcsc.com/product-detail/Tactile-Switches_Omron-Electronics-B3U-1000P_C231329.html) | $0.1729 | $2.5935
28 | IC | U1 | IC REG LDO 3.3V 0.3A SOT23-5 | SOT-23-5 | RT9193-33GB | Richtek | - | C15651 | - | 1 | 10 | 15 | LCSC (https://www.lcsc.com/product-detail/Linear-Voltage-Regulators-LDO_Richtek-Tech-RT9193-33GB_C15651.html) | $0.1154 | $1.7310
29 | IC | U2 | SOT-23-6 Darlington Transistor Arrays ROHS | SOT-23-6 | LK1802 | LANKE | - | C2984831 | - | 1 | 10 | 20 | LCSC (https://www.lcsc.com/product-detail/Darlington-Transistor-Arrays_LANKE-LK1802_C2984831.html) | $0.0531 | $1.0620
30 | IC | U3 | Mainstream Performance line, Arm | 48-LQFP (7x7)_ | STM32F103C8T6 | STMicroelectronics | - | C8734 | - | 1 | 10 | 11 | LCSC (https://www.lcsc.com/product-detail/Microcontroller-Units-MCUs-MPUs-SOCs_STMicroelectronics-STM32F103C8T6_C8734.html) | $1.2553 | $13.8083
31 | Crystal | X1 | 8MHz 20pF ±20ppm HC-49S Crystals ROHS | Custom | 71008000RW1 | HD | - | C655216 | 8Mhz | 1 | 10 | 20 | LCSC (https://www.lcsc.com/product-detail/Crystals_HD-71008000RW1_C655216.html) | $0.0574 | $1.1480
32 | Crystal | X2 | 32.768kHz 12.5pF ±20ppm MC-306 Crystals ROHS | Custom | MC-306 | Seiko Epson | - | C2650464 | 32.768kHz | 1 | 10 | 15 | LCSC (https://www.lcsc.com/product-detail/Crystals_Seiko-Epson-MC-306-32-7680K-A0-ROHS_C2650464.html) | $0.2728 | $4.0920
33 | Peripheral | - | 19mm Waterproof Momentary Latching Metal Doorbell Bell Horn Push Button Switch LED Ring Mark Fixation 5V 12V 24V 220 Lock Reset | - | White LED Button | - | - | - | - | 3 | 30 | 32 | Aliexpress (https://vi.aliexpress.com/item/32899654309.html?gatewayAdapt=glo2vnm) | $0.6900 | $22.0800
34 | Peripheral | - | 19mm Waterproof Momentary Latching Metal Doorbell Bell Horn Push Button Switch LED Ring Mark Fixation 5V 12V 24V 220 Lock Reset | - | Red LED Button | - | - | - | - | 2 | 20 | 22 | Aliexpress (https://vi.aliexpress.com/item/32899654309.html?gatewayAdapt=glo2vnm) | $0.6900 | $15.1800
35 | Peripheral | - | 10A 250V C13 C14 Waterproof Black electric bicycle car wired Receptacle Connector battery Charging AC power outlet Socket | - | - | - | - | - | - | 1 | 10 | 10 | Aliexpress (https://www.aliexpress.us/item/1005004421431950.html?gatewayAdapt=4itemAdapt) | $3.2300 | $32.3000
36 | Peripheral | - | Original For Panasonic CR2032 CR 2032 DL2032 ECR2032 Lithium Battery Watch Calculator Car Key Remote Control Button Coin Cells | - | CR2032 | Panasonic | - | - | - | 1 | 10 | 10 | Aliexpress (https://vi.aliexpress.com/item/1005005930259581.html) | $3.1800 | $31.8000
37 | Peripheral | - | Network cables ROHS | - | LDS200-100726-200-4P | DEALON |  | C2999019 | - | 1 | 10 | 10 | LCSC (https://www.lcsc.com/product-detail/Network-cables_DEALON-LDS200-100726-200-4P_C2999019.html) | $0.1147 | $1.1470
38 | Peripheral | - | 162 16X2 1602 AIP31068L Serial I2C IIC Character LCD Module Display Screen LCM for Arduino RaspBerry Pi PICO ESP32 Jetson Nano | - | - | - | - | - | - | 1 | 10 | 10 | Aliexpress (https://www.aliexpress.com/item/4000386970133.html) | $6.2900 | $62.9000
 |  |  |  |  |  |  |  |  |  |  |  | Total Component Cost |  |  | $218.86
 |  |  |  |  |  |  |  |  |  |  |  | Single Board Cost |  |  | $21.89
