eSpark-Consulting-Group/elijahkorp-controlproject/Design_files/Control_Board/Deliverables/BOM/Free Documents.xlsx

 |  | Component list |  | Bill of Materials for PCB Document [Control_Board-v1.0.PcbDoc]
 |  | Source Data From: |  | Control_Board-v1.0.PcbDoc
 |  | Project: |  | Free Documents
 |  | Variant: |  | None
# | Item Type | Designator | Description | Footprint | Manufacturer Part Number | Manufacturer | #Column Name Error:' Alternate Part Number | LCSC Part Number | Comment | Quantity | #Column Name Error:' Quantity (5 Boards) | #Column Name Error:' MOQ (5 Boards) | #Column Name Error:' Links | #Column Name Error:' Unit Cost (5 Boards) | #Column Name Error:' Total Cost (5 Boards) | #Column Name Error:' Remarks | #Column Name Error:' Reviewer Remarks
1 |  | C1, C2, C5, C7, C13, C14, C15, C16 | CS Series 0603 0.1 uF 25 V ±10% X7R Multilayer Ceramic Capacitor | Cap-0603 | CS0603KRX7R8BB104 | Yageo |  |  | 0.1uF | 8 | 40 |  |  |  | $0.0000
2 |  | C3, C6 | CAP CER 10UF 25V X5R 0603 | Cap-0603 | CL10A106MA8NRNC | Samsung |  | C96446 | 10uF | 2 | 10 |  |  |  | $0.0000
3 | Capacitor | C4 | 25V 22nF X7R 0603 Multilayer Ceramic Capacitors MLCC - SMD/SMT ROHS | Cap-0603 |  |  |  |  | 22nF | 1 | 5 |  |  |  | $0.0000
4 |  | C8, C11 | CAP 30pF NP0 0603 50 V ±5 % SMD | Cap-0603 | CC0603JRNPO9BN300 | Yageo |  | C113797 | 30pF | 2 | 10 |  |  |  | $0.0000
5 | Capacitor | C9, C12 | CAP CER 15PF 50V C0G/NPO 0603 | Cap-0603 | CC0603JRNPO9BN150 | Yageo |  | C107037 | 15pF | 2 | 10 |  |  |  | $0.0000
6 | Capacitor | C10 | 1uF 25V X5R ±20% 0603 Multilayer Ceramic Capacitors MLCC - SMD/SMT ROHS | Cap-0603 |  | CCTC |  |  | 1uF | 1 | 5 |  |  |  | $0.0000
7 | Diode | D1 | TVS DIODE 5VWM 6.3VC DSN0603-2 | DSN0603-2 | PESD5V0H1BSFYL | Nexperia |  | C477989 | PESD5V0H1BSFYL | 1 | 5 |  |  |  | $0.0000
8 | Diode | D2 |  | SOT-23 |  | Shandong Jingdao Microelectronics |  |  | BAT54C | 1 | 5 |  |  |  | $0.0000
9 | Fuse | F1 | PTC RESET FUSE 6V 3A 1206 | Fuse 1206 (3216 Metric) | 1206L300SLTHYR | Littelfuse |  | C207041 | 1206L300SLTHYR | 1 | 5 |  |  |  | $0.0000
10 | Ferrite Bead | FB1 | FERRITE BEAD 120 OHM 1206 1LN | IND-1206 | BLM31PG121SN1L | Murata |  | C85841 | 100MHz | 1 | 5 |  |  |  | $0.0000
11 | PCB Welding Terminal | J1, J14 | 7.5mm 240A 20mm M6 - PCB Welding Terminal ROHS | ACTB273-CU-T2 | ACTB273-Cu-T2 | CNNT(Shenzhen Connection Elec) |  |  | ACTB273-Cu-T2 | 2 | 10 |  |  |  | $0.0000
12 | Terminal Block | J2, J3 | Tin 2x1P 2 1 7.62mm -40℃~+105℃ 20A 300V Green 12~22 Straight pin Copper Alloy 2.5 Plugin,P=7.62mm Barrier Terminal Blocks ROHS | MX7620-7.62-02P-GN01-Cu-S-A |  |  |  |  | MX7620-7.62-02P-GN01-Cu-S-A | 2 | 10 |  |  |  | $0.0000
13 | USB | J4 | 1.8A USB 2.0 1 260℃ Surface Mount 5P Female -40℃~+85℃ Gold Copper Alloy Micro-B SMD USB Connectors ROHS | U254-051T-4BH83-F1S |  |  |  |  | U254-051T-4BH83-F1S | 1 | 5 |  |  |  | $0.0000
14 | Header | J5, J6 | Straight 2.54mm Black Brass 1x4P Plugin,P=2.54mm Pin Headers ROHS | HDR1X4_ | B-2100S04P-A110 | Ckmtw |  | C124378 | B-2100S04P-A110 | 2 | 10 |  |  |  | $0.0000
15 | Through Hole Pads | J7, J8, J9, J10, J12 | Wire Connecting Pads | 5P Through Hole Pads | 5P Through Hole Pads |  |  |  | DNP | 5 | 25 |  |  |  | $0.0000
16 | Connector | J11 | 1x4P 1 2mm Male pin 4 -25℃~+85℃ 2A Surface Mount SMD,P=2mm Wire To Board / Wire To Wire Connector ROHS C3029442 | WAFER-PH2.0-4PWB |  |  |  |  | WAFER-PH2.0-4PWB | 1 | 5 |  |  |  | $0.0000
17 | Connector | J13 | Battery base CR2032 SMD Battery Connectors ROHS | CR2032-BS-6-1 |  | Q&J |  |  | CR2032-BS-6-1 | 1 | 5 |  |  |  | $0.0000
18 | Relay | K1, K2 | 5V 10A 20A@14VAC SPDT (1 Form C) 5 Plugin,12.4x16mm Power Relays ROHS | SRA-05VDC-CL | SRA-05VDC-CL | Ningbo Songle Relay |  | C99666 | SRA-05VDC-CL | 2 | 10 |  |  |  | $0.0000
19 | LED | LED6 | Colorless transparence -30℃~+85℃ Positive post 617nm~621nm Red 120° 55mW 0603 Light Emitting Diodes (LED) ROHS | LED-0603 |  | XINGLIGHT |  |  | RED | 1 | 5 |  |  |  | $0.0000
20 | TEST POINT | P1, P2, P3 | Test Point ON | Test-point |  |  |  |  | TEST POINT | 3 | 15 |  |  |  | $0.0000
21 | Resistor | R1, R2 | 100mW Thick Film Resistors ±100ppm/℃ ±1% 20Ω 0603 Chip Resistor - Surface Mount ROHS | Res-0603 |  | UNI-ROYAL(Uniroyal Elec) |  |  | 20R | 2 | 10 |  |  |  | $0.0000
22 | Resistor | R3 | RES SMD 4.7K OHM 5% 1/10W 0603 | Res-0603 | RC0603JR-074K7L | Yageo |  | C105428 | 4.7K | 1 | 5 |  |  |  | $0.0000
23 | Resistor | R4, R5, R7, R9, R10, R11, R12, R18 | RES SMD 10K OHM 0.1% 1/10W 0603, RES SMD 10K Ohm 1% 1/10W 0603 | Res-0603 | RT0603BRD0710KL, RC0603FR-0710KL | Yageo |  | C95204, C98220 | 10K | 8 | 40 |  |  |  | $0.0000
24 |  | R6 | 100mW Thick Film Resistors ±100ppm/℃ ±1% 60.4Ω 0603 Chip Resistor - Surface Mount ROHS | Res-0603 |  |  |  |  | 60.4R | 1 | 5 |  |  |  | $0.0000
25 | Resistor | R8 | 100mW Thick Film Resistors ±100ppm/℃ ±1% 1MΩ 0603 Chip Resistor - Surface Mount ROHS | Res-0603 |  | UNI-ROYAL(Uniroyal Elec) |  |  | 1M | 1 | 5 |  |  |  | $0.0000
26 | Resistor | R13, R14, R15, R16, R17 | RES SMD 330R 100 mW 0603 | Res-0603 | RC0603JR-07330RL | Yageo |  | C105879 | 330R | 5 | 25 |  |  |  | $0.0000
27 | Switch | SW1 | SWITCH TACTILE SPST-NO 0.05A 12V | B3U-1000P | B3U-1000P | Omron |  | C231329 | B3U-1000P | 1 | 5 |  |  |  | $0.0000
28 |  | U1 | IC REG LDO 3.3V 0.3A SOT23-5 | SOT-23-5 | RT9193-33GB | Richtek |  |  | RT9193-33GB | 1 | 5 |  |  |  | $0.0000
29 | IC | U2 | SOT-23-6 Darlington Transistor Arrays ROHS | SOT-23-6 |  | LANKE |  |  | LK1802 | 1 | 5 |  |  |  | $0.0000
30 |  | U3 | ARM Cortex-M3 STM32 F1 Microcontroller 32-Bit 72MHz 64kB FLASH LQFP48 STM32F103C8T6 | 48-LQFP (7x7)_ | STM32F103C8T6 | STMicroelectronics |  |  | STM32F103C8T6 | 1 | 5 |  |  |  | $0.0000
31 | Crystal | X1 | 8MHz 20pF ±20ppm HC-49S Crystals ROHS | 71008000RW1 |  |  |  |  | 8Mhz | 1 | 5 |  |  |  | $0.0000
32 | Crystal | X2 | 32.768kHz 12.5pF ±20ppm MC-306 Crystals ROHS | MC-306 |  | Seiko Epson |  |  | 32.768kHz | 1 | 5 |  |  |  | $0.0000
 |  |  |  |  |  |  |  |  |  |  |  | Total Component Cost |  |  | #REF!
 |  |  |  |  |  |  |  |  |  |  |  | Single Board Cost |  |  | #REF!
