eSpark-Consulting-Group/elijahkorp-controlproject/Design_files/Control_Board/Deliverables/Supporting_Files/Control_Board-v1.0.step

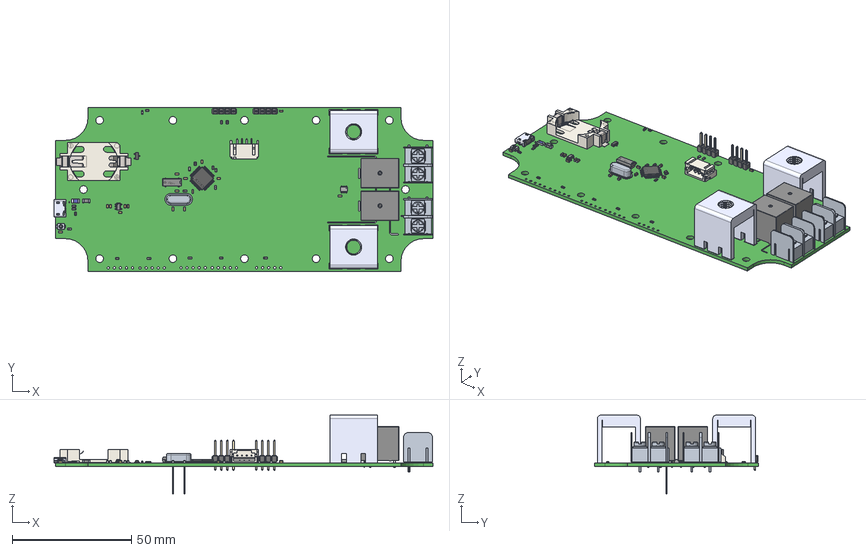
[picture p7: CAD file, 2024-02-02]
Design_files/Control_Board/Deliverables/Supporting_Files/Control_Board-v1.0.step
158.9 x 68.7 x 33.0 mm
ACTB273-Cu-T2 x 2
U254-051T-4BH83-F1S_U254-051T-4BH83-F1S
SOLID.step x 3
User_Library-RESC1608X05N x 18
User_Library-CAPC1608X09 x 16
User_Library-LED_SMD0603
CircuitWorks-SOT-23
User_Library-mc-306_crystal
71008000rw1
User_Library-P-LQFP48-7x7-0_50
21-0058I_MXM
SN74LV1T34DBVR
User_Library-OMRON_B3U1000P
WAFER-PH2.0-4PWB
holder x 2
pin x 8
mx7620-7_62-02p-gn01-cu-s-a x 2
BLM31PG121SN1L
0685H9150-01
PESD5V0H1BSF
