eSpark-Consulting-Group/elijahkorp-controlproject/(list of files, cad)

Other CAD files:
Design_files/Control_Board/Deliverables/Supporting_Files/Control_Board-v1.0.DWG
Design_files/Control_Board/Deliverables/Supporting_Files/Control_Board-v1.0.DXF
