eSpark-Consulting-Group/elijahkorp-controlproject/Design_files/Control_Board/Deliverables/Schematic/Control_Board-v1.0.pdf

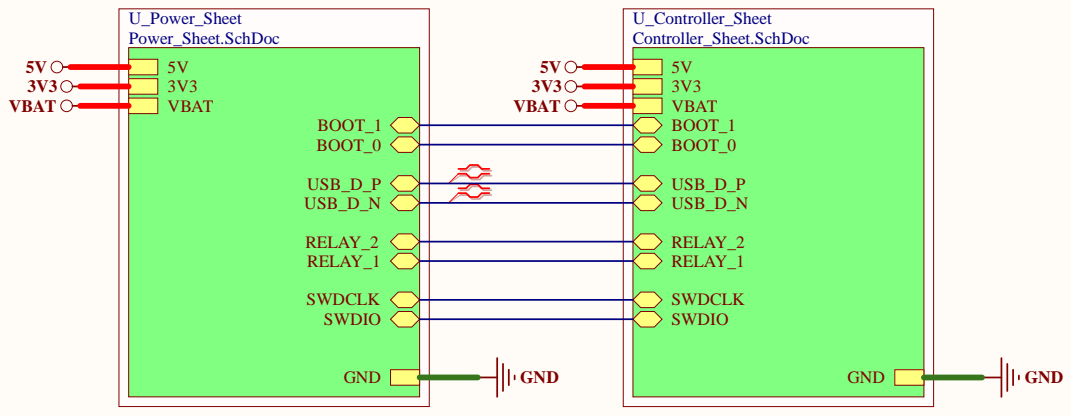
[picture p8: page 1]

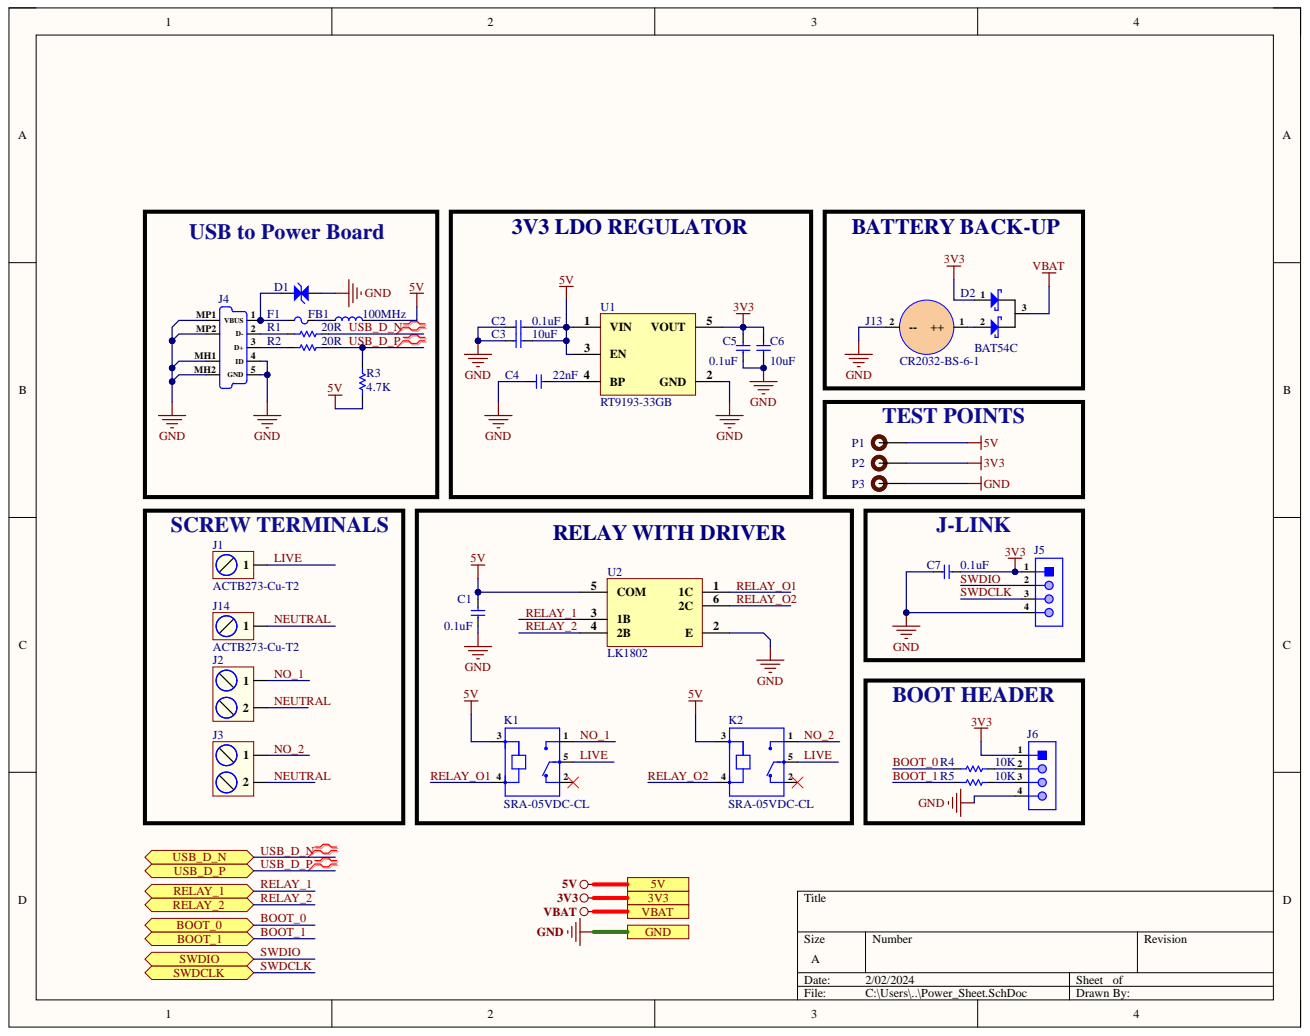
[picture p9: page 2]

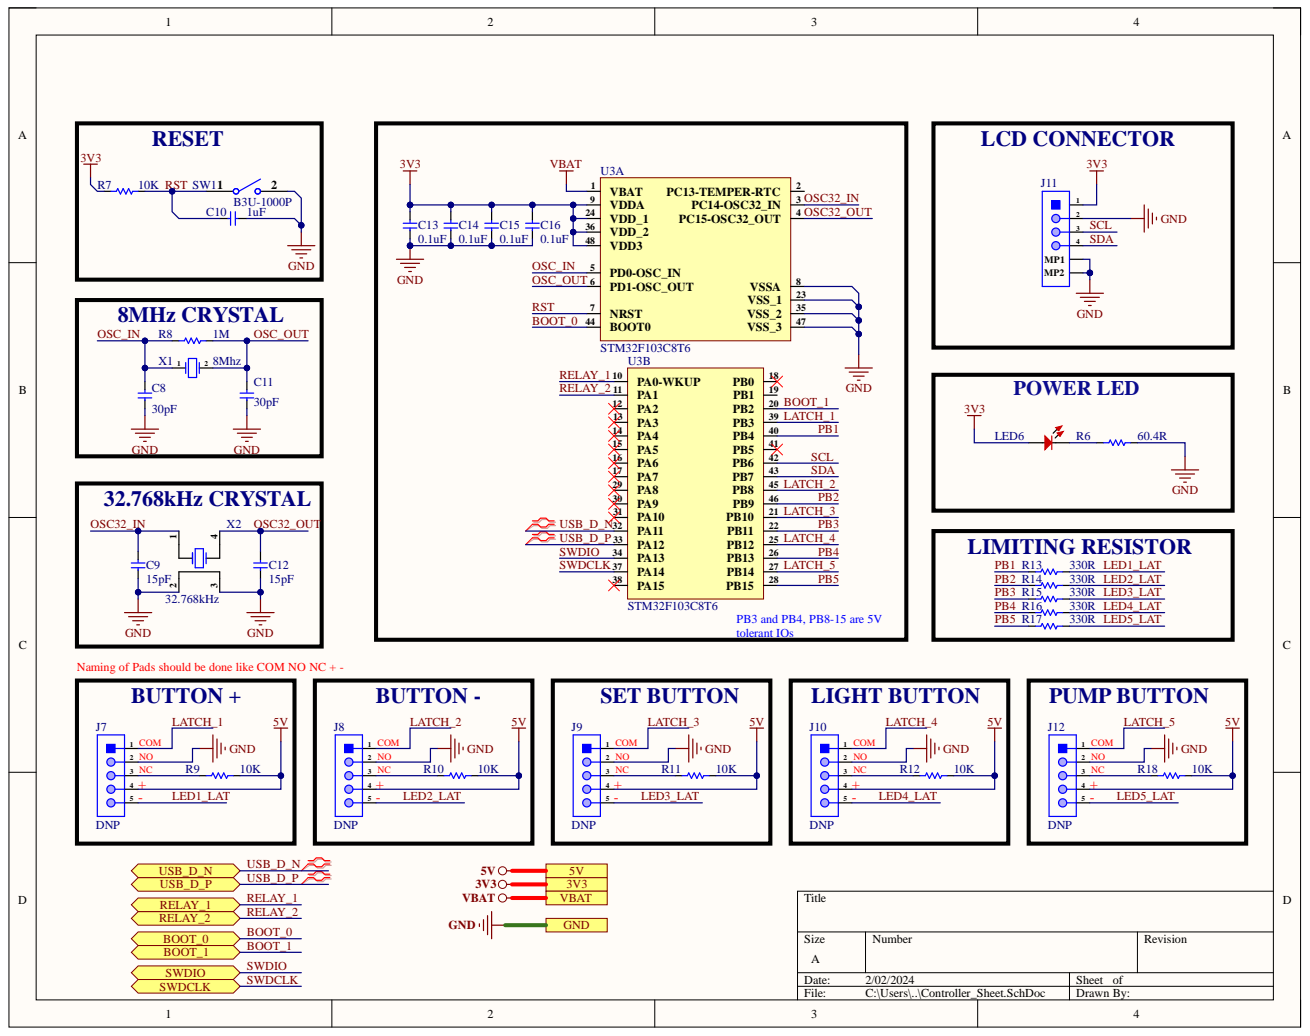
[picture p10: page 3]

Naming of Pads should be done like COM NO NC + -
BUTTON +
