eSpark-Consulting-Group/elijahkorp-controlproject/Design_files/Control_Board/Deliverables/Schematic/Assembly_Drawing.pdf

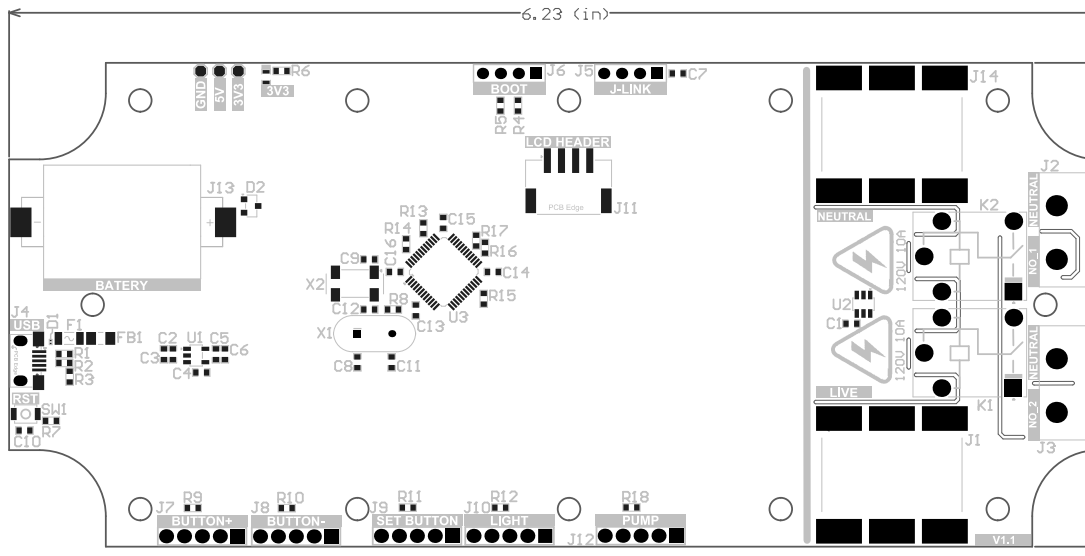
[picture p11: page 1]

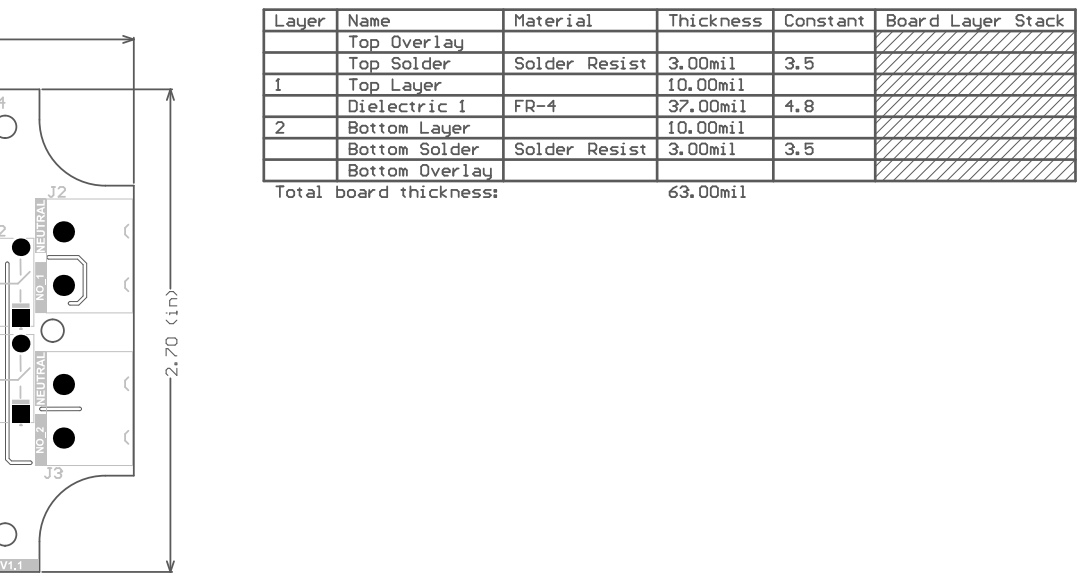
[picture p12: page 2]

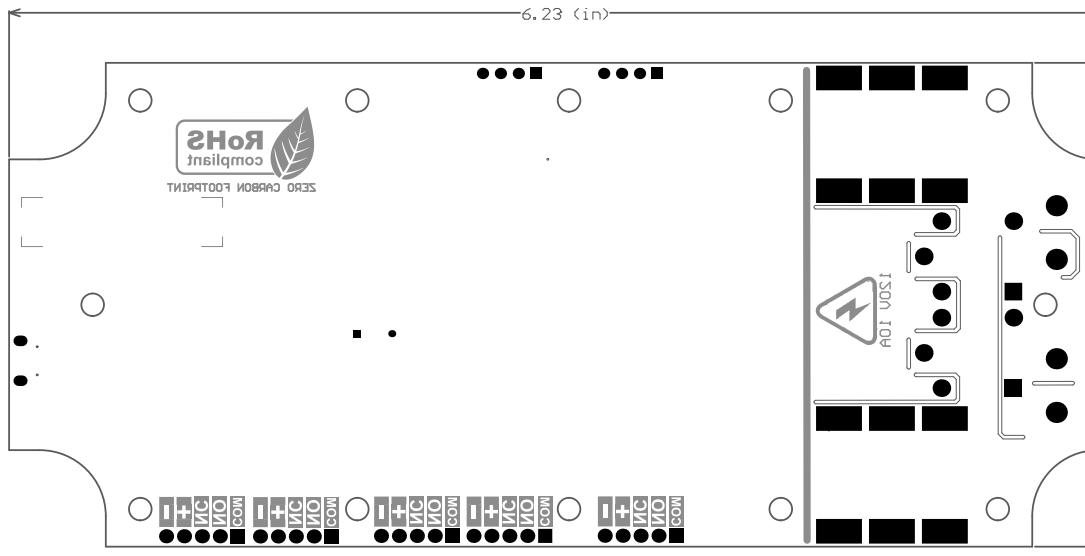
[picture p13: page 3]

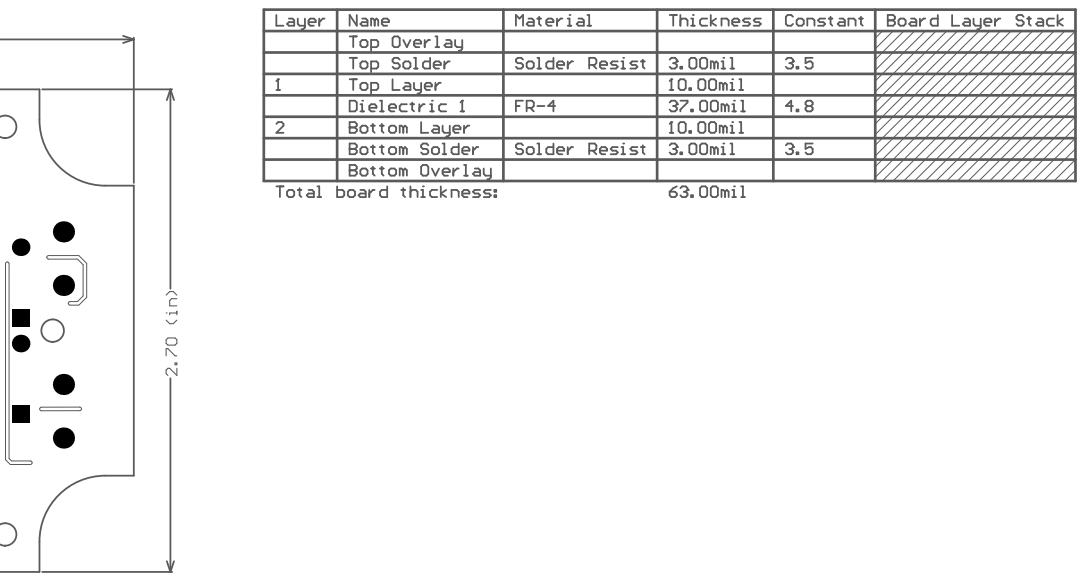
[picture p14: page 4]
