eSpark-Consulting-Group/elijahkorp-controlproject/(list of files, drawings)

Other design files:
Control_Board/Control_Board/Control_Board.PrjPcb
Design_files/Control_Board/Control_Board-v1.0.PcbDoc
Design_files/Control_Board/Control_Board-v1.0.PrjPcb
Design_files/Control_Board/Control_Board.PrjPcb
Design_files/Control_Board/Controller_Sheet.SchDoc
Design_files/Control_Board/Power_Sheet.SchDoc
Design_files/Control_Board/Top_Sheet.SchDoc
