eSpark-Consulting-Group/elijahkorp-controlproject/(commit log)

2023-10-24 PCB info updated in PRD
2023-10-25 #2 Schematic in Progress
    [Control_Board.PcbDoc, Control_Board.PrjPcb, Controller_Sheet.SchDoc, Powe_Sheet.SchDoc]
2023-10-30 #2 Completed! Parts Placement in Progress
    [Control_Board.PcbDoc, Control_Board.PrjPcb, Controller_Sheet.SchDoc, Power_Sheet.SchDoc, Top_Sheet.SchDoc]
2023-10-31 #4 Placement in progress
    [Control_Board.PcbDoc, Controller_Sheet.SchDoc, Power_Sheet.SchDoc, Top_Sheet.SchDoc]
2023-11-01 #4 routing in Progress
    [Control_Board.PcbDoc, Power_Sheet.SchDoc]
2023-11-02 #4 Routing completed(some drc errors remaining)
    [Control_Board.PcbDoc, Control_Board.PrjPcb, Controller_Sheet.SchDoc, Power_Sheet.SchDoc, Top_Sheet.SchDoc]
2023-11-03 #4 Routing compeleted
    [Control_Board.PcbDoc, Power_Sheet.SchDoc]
2023-11-03 #5 Client BOM Completed.
    [Control_Board.xlsx, eSpark BOM.xlsx]
2023-11-03 #5 Updated files
    [Client BOM.xlsx, Control_Board.xlsx]
2023-11-03 #5 Peripheral Qty corrected
    [Client BOM.xlsx]
2023-11-06 #6 Review done: Deliverables remaining.
    [Control_Board-v1.0.PcbDoc, Control_Board-v1.0.PrjPcb, Control_Board-v1.0.step, Control_Board.PcbDoc, Controller_Sheet.SchDoc, Power_Sheet.SchDoc, Top_Sheet.SchDoc]
2023-11-07 #6 Done: Fresh Deliverables done: Modification in Routing and Board cutouts.
    [Centroid_File-v1.0.csv, Client BOM.xlsx, Control_Board-v1.0.DWG, Control_Board-v1.0.DXF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]
2023-11-07 #6 Updated Assembly Drawing File.
    [Control_Board-v1.0.PcbDoc, Control_Board-v1.0.PrjPcb]
2023-11-13 Routing updated to give 10mil clearance from cutout to fills
    [Control_Board-v1.0.PcbDoc]
2023-11-14 #6 Fresh deliverables generated
    [Centroid_File-v1.0.csv, Centroid_File.csv, Control_Board-v1.0.DWG, Control_Board-v1.0.DXF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]
2023-11-15 #6 displace lcd header. Fresh deliverables generated acc to updated changes
    [Centroid_Files.csv, Control_Board-v1.0.DWG, Control_Board-v1.0.DXF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]
2023-11-15 pick n place removed from gerbers folder
    [Pick Place for Control_Board-v1.0.csv]
2023-11-20 #5 eSpark BOM Added.
    [Client BOM.xlsx, eSpark-BOM-Control_Board-v1.0.xlsx]
2024-01-29 #8 R3 on USB_D_P placed correctly.
    Pullup using 4.7k on USB_D_P as in datasheet.
    [Power_Sheet.SchDoc]
2024-01-31 #8 Update terminal block
    [Power_Sheet.SchDoc]
2024-02-01 #8 Changes In-Progress.
    [Control_Board-v1.0.PcbDoc, Power_Sheet.SchDoc]
2024-02-02 #8 PCB Design v1.1 Complete.
    [Control_Board-v1.0.PcbDoc]
2024-02-02 #10 Fresh Deliverables after #7.
    [Centroid_File-Control_Board-v1.0.csv, Centroid_Files.csv, Control_Board-v1.0.DWG, Control_Board-v1.0.DXF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]
2024-03-21 #12 BOM updated with R3 and Terminal block 10K resistor updated in Sch: and PCB as well
    [Client BOM.xlsx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]
